Zauros98/MaquinaCNC/README.md

 
# **Univeridad  Politecnica de Tulancingo** 

### **Alumno:** 
**Luis Felipe González Luqueño**
### **Docente:**
**Arturo Negrete Medellin**
### **Proyecto:**
**Maquina CNC**

------------

### **Introduccion**
 
##### **¿Qué es una maquina CNC?**
Una máquina CNC es un dispositivo controlado vía computadora habilitado para tratar materiales como madera, foami, plástico, MDF, metal, entre muchos otros. CNC son las siglas en inglés de Computer Numerical Control (Control numérico de computadoras).

##### **¿Cómo funcionan las máquinas CNC?**
Por medio de la lectura de códigos digitales de software de Diseño de Apoyo Computacional (CAD por sus siglas en inglés) o Manufactura de Apoyo Computacional (CAM), las máquinas CNC logran seguir una ruta dirigida por computadora a medida que cortan una pieza en orden de convertirla en lo deseado.

### **Materiales**
- Unidad de DVD de chatarra(2)
- Arduino UNO 
- PROTECTOR DEL MOTOR L293D
- MINI SERVO MOTOR
- ADAPTADOR DE CORRIENTE 5V 1Amps
- ALGUNOS HILOS PARA CONEXIÓN DE MOTOR
- TUERCA Y PERNOS SEGÚN SE REQUIERA

### **LISTA DE SOFTWARE**
- [IDE ARDUNIO](https://www.arduino.cc/en/main/software)
- [IDE DE PROCESAMIENTO](https://processing.org/download/)
- [VERSIÓN INKSCPAE 0.48.5](https://inkscape.org/release/inkscape-0.48/?latest=1)

------------

### **Armado de maquina**
El armado se encuentra en la presentación enviada por classroom al Profesor Arturo Negrete Medellín, de igual manera se encuentra en un archivo adjuntado a este mismo repositor o de igual manera en [Exposición de proyecto](https://drive.google.com/file/d/1ItUyIfZDlvqNN5MA2FtoA6MNPPQivgV8/view?usp=sharing)

### **Código de Arduino**
El código se encuentra de igual manera en un archivo adjuntado en este repositor o en [Código Arduino](https://drive.google.com/file/d/146uGw6wSoPIxd1NurPImDQu-W8Zope0d/view?usp=sharing)

### **¿A quien va dirigido?**
Va dirigido para aquellos que necesitan realizar algún dibujo para alguna presentación y en caso de modificaciones que en vez de que lleve un lapicero puede llevar un mini dril para desarrollar tallados y circuitos o a su vez utilizar un laser para un grafilado o si se le llega a poner un eje Z se puede utilizar como impresora 3D





## ** Creditos **
A [Mr Innovative](https://www.youtube.com/channel/UCsOFElmDD3e8l-RGCabCZ9g) por darme la idea de realizar este proyecto mediante uno de sus videos tiene un grna contenido en su canal y este es el [video](https://www.youtube.com/watch?v=Gm6bH3p6cNQ&list=PLxnbttCfosG-A2YgYmtzCLAhpN4TjThBH&index=9) de donde obtuve la idea 
